Alex-B13/LEMSv2/Hardware Information/LEMSv2-GPS-files/RelayConnections.png

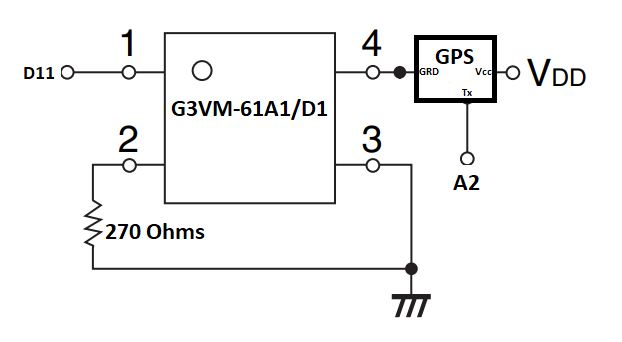
Hardware Information/LEMSv2-GPS-files/RelayConnections.png
