Alex-B13/LEMSv2/Hardware Information/Wiring Information v2_1.xlsx

Connections are to be made from node to node going left to right via edges
When referring to left (LHS) or right (RHS) of the LEMS shield, the SD Card connector is on top
SHT31: | Use gray 4-wire multi-strand cable for connections
VIN | Solder | Red Sub-Wire | Screw | "3.3V" on RHS of LEMS Shield
GND | Solder | Black Sub-Wire | Screw | "GND" on RHS of LEMS Shield
SCL | Solder | White Sub-Wire | Screw | "SCL" on RHS of LEMS Shield
SDA | Solder | Green Sub-Wire | Screw | "SDA" on RHS of LEMS Shield
MLX90614: | Use gray 4-wire multi-strand cable for connections
VIN | Solder | Red Sub-Wire | Screw | "3.3V" on RHS of LEMS Shield
GND | Solder | Black Sub-Wire | Screw | "GND" on RHS of LEMS Shield
SCL | Solder | White Sub-Wire | Screw | "SCL" on RHS of LEMS Shield
SDA | Solder | Green Sub-Wire | Screw | "SDA" on RHS of LEMS Shield
Li200R: | No intermediate wire necessary. Note: Different Li200s have different wiring. The two configurations are below
Blue | Screw | "LI+" on LHS of LEMS Shield
Brown+Shield | Screw | "LI-" on LHS of LEMS Shield
OR
Shield | Screw | "Li+" on LHS of LEMS Shield
Copper | Screw | "Li-" on LHS of LEMS Shield
Davis Anemometer: | No intermediate wire necessary
Black | Screw | "WIND SPD" on RHS of LEMS Shield
Red | Screw | "WIND GND" on RHS of LEMS Shield
Green | Screw | "WIND DIR" on RHS of LEMS Shield
Yellow | Screw | "WIND POW" on RHS of LEMS Shield
Upper Soil (5TM): | No intermediate wire necessary. Note: Two sensors present, either wiring configuration possible
Bare/Shield | Screw | "U5TM GND" on LHS of LEMS Shield
Red | Screw | "U5TM DATA" on LHS of LEMS Shield
White | Screw | "U5TM POW" on LHS of LEMS Shield
OR
Bare/Shield | Screw | "U5TM GND" on LHS of LEMS Shield
Orange | Screw | "U5TM DATA" on LHS of LEMS Shield
Brown | Screw | "U5TM POW" on LHS of LEMS Shield
Lower Soil (5TM): | No intermediate wire necessary. Note: Two sensors present, either wiring configuration possible
 | Screw | "L5TM GND" on RHS of LEMS Shield
Red | Screw | "L5TM DATA" on RHS of LEMS Shield
White | Screw | "L5TM POW" on RHS of LEMS Shield
OR
Bare/Shield | Screw | "L5TM GND" on RHS of LEMS Shield
Orange | Screw | "L5TM DATA" on RHS of LEMS Shield
Brown | Screw | "L5TM POW" on RHS of LEMS Shield
DS2 Anemometer/Atmos 22 Anemometer: | No itermediate wire necessary. Note: This anemometer changed in 2018, so there are two names and two different wiring schemes (as seen below)
Bare/Shield | Screw | "GND" on LHS of LEMS Shield
Red | Screw | "SONIC DATA" on LHS of LEMS Shield
White | Screw | "5V" on LHS of LEMS Shield
OR
Bare/Shield | Screw | "GND" on LHS of LEMS Shield
Orange | Screw | "SONIC DATA" on LHS of LEMS Shield
Brown | Screw | "5V" on LHS of LEMS Shield
Snow Depth Sensor:
White | Screw | "AIN2" on LHS of PCB
Red | Screw | "5V" on LHS of PCB
Solid State Relay
Yellow | Header | "D12" on Sparkfun Board
Black | Screw | "GRD" on LHS of PCB
GPS:
Yellow | Screw | "A2" on Sparkfun Board
Red | Screw | "3.3V" on LHS of PCB
Solid State Relay
Yellow | Header | "D11" on Sparkfun Board
Black | Screw | "GRD" on LHS of PCB
